AleksVidmantas/SlideSentinel/Documentation/Photos/Hardware/Spring2020/GNSS_antenna.jpg

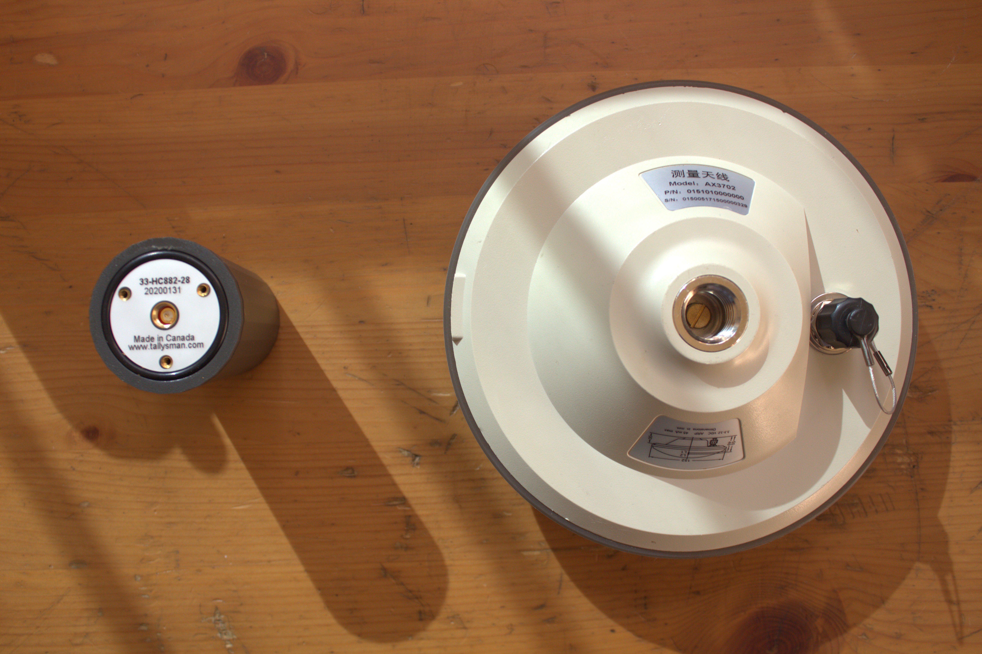
Documentation/Photos/Hardware/Spring2020/GNSS_antenna.jpg
