AleksVidmantas/SlideSentinel/Documentation/Photos/Hardware/Spring2020/sky.jpg

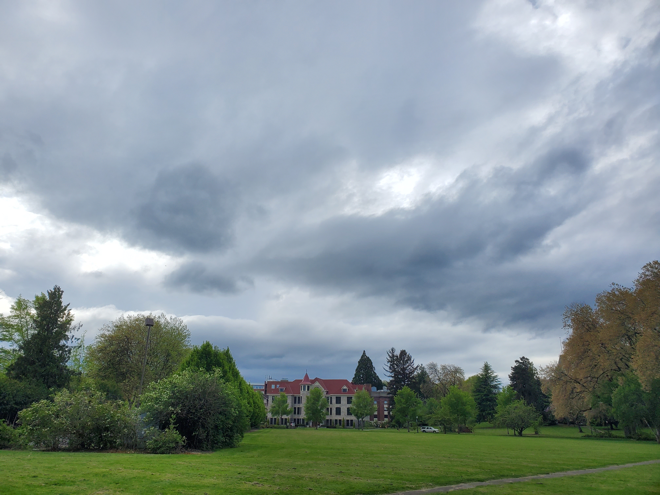
Documentation/Photos/Hardware/Spring2020/sky.jpg
