AleksVidmantas/SlideSentinel/Integration/Network/RefactoredFiles/versionControl/html/class_network.png

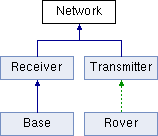
Integration/Network/RefactoredFiles/versionControl/html/class_network.png
