AleksVidmantas/SlideSentinel/Documentation/Photos/Hardware/Spring2020/tallysman.jpg

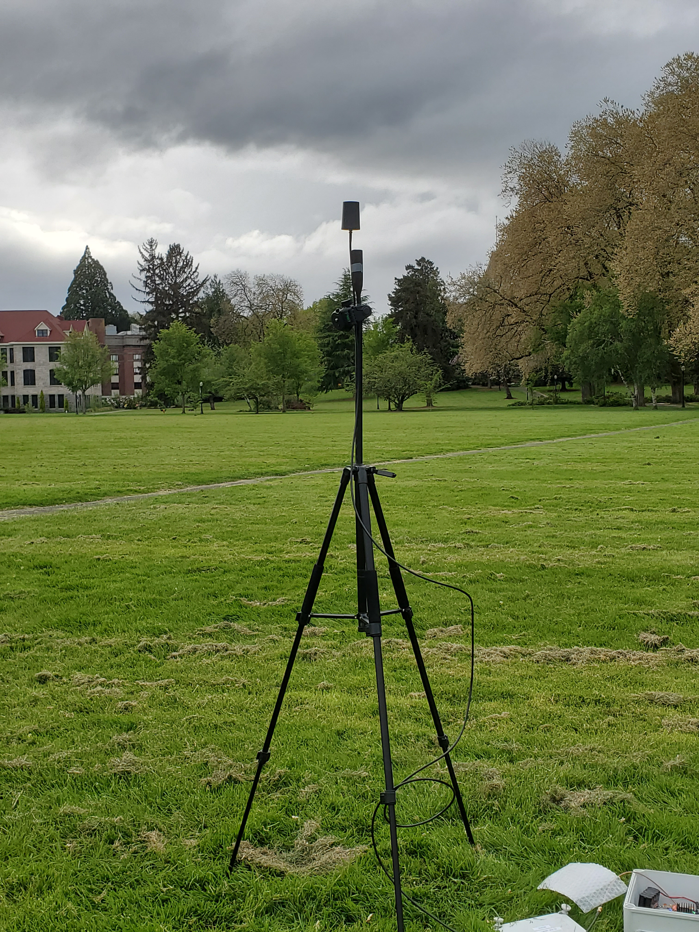
Documentation/Photos/Hardware/Spring2020/tallysman.jpg
